WassonRV10/hangar-mate/presentation/hangar-mate-chapter-talk.pdf

E A A C H A P T E R 3 2 · 1 1 / 2 1 / 2 0 2 6

# PREHEAT FROM HOME

## A cellular Tanis controller you can build yourself — no hangar Wi-Fi, no

monthly fee, and it tells you the engine is actually warming.

Brian Wasson · RV-10 · KSET

T H E P R O B L E M

# The Tanis wants hours. The hangar is 40 minutes

away.

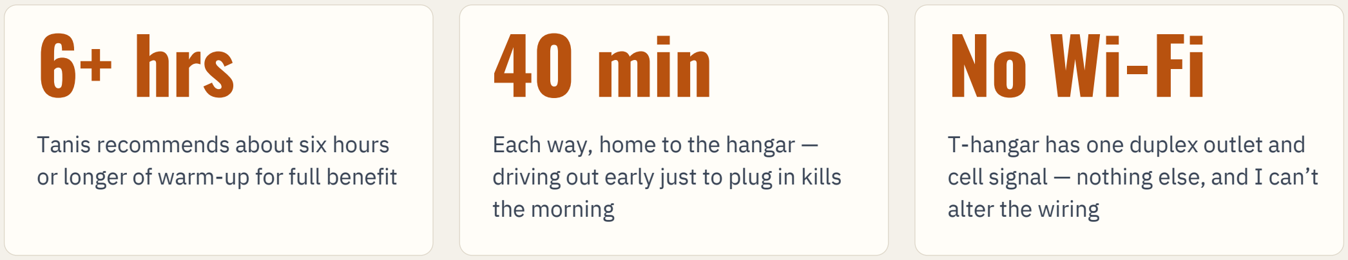
[picture p1: figure]
6+ hrs; Tanis recommends about six hours or longer of warm-up for full benefit; 40 min; Each way, home to the hangar — driving out early just to plug in kills the morning; T-hangar has one duplex outlet and cell signal — nothing else, and I can’t alter the wiring

W H A T ’ S O N T H E S H E L F
Plenty of ways to switch an outlet. Few tell you it worked.
Option | Upfront | Ongoing | Confirms it’s heating?
HangarBot preheat kit | $729 | $15 Monthly data plan | No — switches the outlet
SwitcheOn (sold by Tanis) | $323 | $50/yr | No — switches the outlet
Wi-Fi plug + hotspot | ~$60–100 | Hotspot plan | No — two things to fail
Plug-in timer | ~$30 | None | No — and Tanis says no timers

Prices: Aircraft Spruce listing (HangarBot), Tanis website Oct 2026 (SwitcheOn); verify before quoting.

W H Y I B U I L T O N E

# I wanted confidence, not just a remote switch

### Proof it’s working

Engine and hangar temps on my phone — I see the rise before I leave home

### No monthly bill

Particle’s free plan includes the cellular data for a device like this

### Built around Tanis rules

On means on — no cycling, no timer, no thermostat on the engine heater

### Grows with me

Cabin heat, flood warning and more bolt on later without starting over

E X P A N S I O N P A T H
Start with preheat. Add the rest when you want it.
Add-on | What you add | What you get
Cabin heat | Second relay + cabin probe + ceramic heater | Warm seats, auto shut-off timer
Current sensor | Clamp-on CT on the Tanis circuit | “Confirmed on” in seconds; stuck-relay alarm
Power-loss alert | Small LiPo battery on the controller | Alert when hangar power drops
Flood warning | River-gauge alerts + floor water sensor | Lead time to fly the airplane out
Activity & lights | Motion sensor + light sensor | FBO visit log; lights-left-on alert

The controller has spare inputs for all of these. No rewiring of what you already built.

T H E C U R R E N T B U I L D
Two relays. Three temperature probes. One phone.

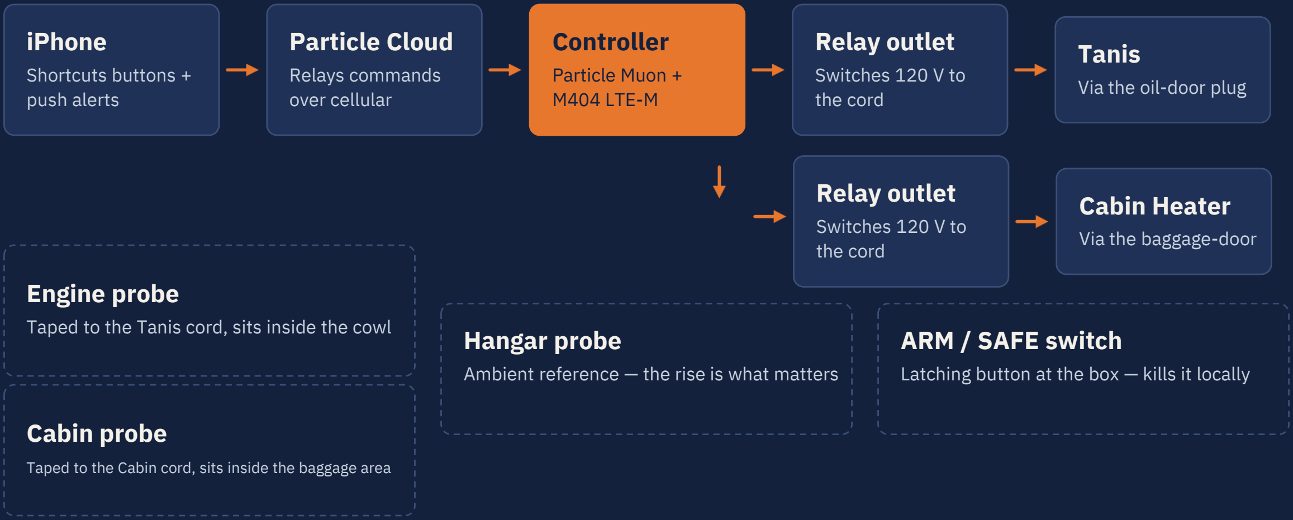
[picture p2: figure]
iPhone; Shortcuts buttons + push alerts; Particle Cloud; Relays commands over cellular; Controller; Particle Muon + M404 LTE-M; Relay outlet; Switches 120 V to the cord; Tanis; Via the oil-door plug; Engine probe; ARM / SAFE switch; Cabin Heater; Via the baggage-door; Cabin probe

Taped to the Tanis cord, sits inside the cowl | Hangar probe
| Ambient reference — the rise is what matters

Latching button at the box — kills it locally

Taped to the Cabin cord, sits inside the baggage area

# THE FULL BUILD

# 5V Power DINRail

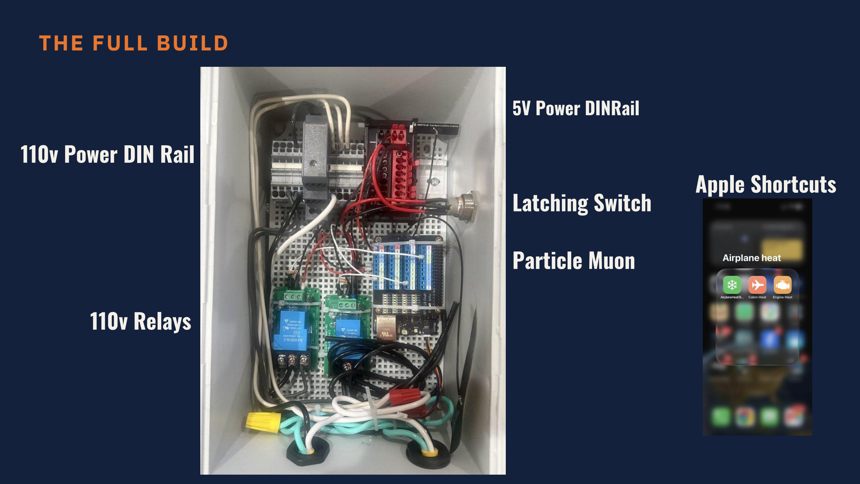
[picture p3: page 7]

# 110v Relays

# Particle Muon

# Latching Switch

# 110v Power DIN Rail Apple Shortcuts

F A I L -S A F E B Y D E S I G N

# When anything fails, the heat goes off — not on

If this happens… | …the result is
Controller dies or loses power | Relay drops open — outlet off
Cell signal or cloud goes down | Outlet holds its state; phone shows “state unknown”
ARM/SAFE button set to SAFE | Relay can’t energize, in hardware, whatever the firmware does
Re-armed after SAFE | Stays off until someone sends a new command
Fueling or engine start | Use your head - Unplugged first!

Kit and bridge prices from vendor listings, Oct 2026. total is an estimate.

W H A T I T C O S T S

Part | Approx.
Particle Muon kit, North America (M404 LTE-M) | $85
2 - 30 A relay module, opto-isolated input | $5
Waterproof DS18B20 probes (3 pack) | $6
Adafruit DS2484 probe bridge + Qwiic cable | $15
Mean Well 12v DIN rail power supply | $14
8 out DIN rail power distribution | $15
Plastic NEMA 4 box, 15 A; with DIN Rail | $38
Latching lit button, screw-terminal HAT, resistors | $19
12-ga outdoor extension cord (if needed) | $25
2 ft 12-ga outlets | $17
3 conductor 22 awg 50ft | $20
Deutsch Connectors | $10
WAGO DIN rail connector | $15
TOTAL | $284

Estimated total

~$284

Monthly

$0

Particle Free Plan: up to 100 devices, 100K data operations/month, cellular data included

W H A T I T T A K E S T O B U I L D O N E

# If you can wire a panel, you can build this

### Skills

Relays module and pigtail outlets in an electrical box, screw terminals and a multimeter. Simpler than any panel you’ve wired.

### Software

No coding. Set up the device in a browser, flash my shared firmware, install iPhone Shortcuts.

### Time

An evening on the bench, an hour at the hangar, then a 24–48 hour soak test before you trust it.

You’ll need: an iPhone, cell signal inside your hangar (we test that first), and a Tanis or similar plug-in preheater.

I N S I D E T H E B O X

# Four details that make it fail safe

### Load on COM → NO, never NC

A dead relay means a dead outlet. Wired through NC, it would heat whenever the controller is off.

### Active-high + 15 kΩ pull-down

In active-low mode the outlet came on at power-up. Active-high keeps it off before firmware runs.

### ARM/SAFE cuts relay power

The latching button is in the relay’s 5 V feed. SAFE means no coil power, whatever the code does.

### Non-metallic enclosure

Non-metallic electrical enclosure. Listed polycarbonate recommended to contain a 120 V fault near fuel; doesn’t block the cellular antenna..

# Build a Minimum Product

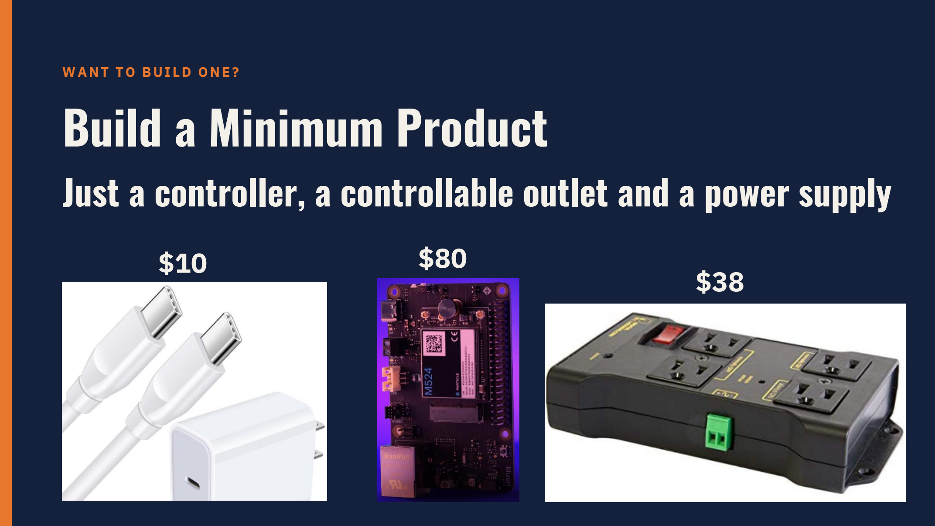
[picture p4: page 12]

W A N T T O B U I L D O N E ?

$80
$38

# Just a controller, a controllable outlet and a power supply

$10

# Project Documentation

GitHub Repository:

WassonRV10/hangar (https://github.com/WassonRV10/hangar-mate)- (https://github.com/WassonRV10/hangar-mate)mate: Cellular Pre (https://github.com/WassonRV10/hangar-mate)- (https://github.com/WassonRV10/hangar-mate)heat manager (https://github.com/WassonRV10/hangar-mate)
