WassonRV10/hangar-mate/presentation/README.md

# Presentation

EAA chapter presentation: "Preheat From Home — DIY Cellular Hangar Controller."

See `hangar-mate-chapter-talk.pdf`.
