WassonRV10/hangar-mate/(commit log)

2026-11-02 Add relay firmware with toggle; update guide for one-tap Preheat Shortcut
    - firmware/src/hangar_mate.ino: tanis/cabin accept toggle; return codes
    report resulting state (1 on, 0 off, -1 bad arg, -2 SAFE); every
    command refused while SAFE; sense pin INPUT_PULLDOWN; no Tanis timer
    - firmware/README.md: implemented interface vs. still-to-come
    - docs/builders-guide.md: Preheat toggle Shortcut, return-code table,
    build steps, bench tests and troubleshooting updated
    - README.md: status and layout
    Claude-Session: https://claude.ai/code/session_018Rj49QWAzRy1FNSQnHF3T7
    [hangar_mate.ino]
2026-11-02 Presentation PDF: correct probe cost and total ($286)
    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
2026-11-07 PRD v0.19: merge Section 9A to match firmware; bring in v0.18 FR-003a
    - Section 9A merged into docs/PRD.md and updated to the firmware as built:
    tanis/cabin on|off|toggle, return codes report resulting state, -2 for
    SAFE or not-yet-read, implemented variables and events
    - Owner decisions: Phase 1 allowance on IF-003 (labeled 'heat not yet
    confirmed'), cabin duration argument dropped, 8-12 V DIN-rail supply
    to VIN, LoRaWAN not used
    - New IF-010: no automatic retry (toggle is not idempotent)
    - Draft open items 32-37 renumbered 36-40 to avoid Section 25 collisions
    - Stale 'M-SoM not yet selected' text updated
    - Builder's guide, README and firmware README updated to match
    Co-Authored-By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
2026-11-07 PRD v0.20: record Joinfworld enclosure as accepted deviation from ER-005
    Claude-Session: https://claude.ai/code/session_018Rj49SwcFPazYrWtiNanW4
2026-11-07 Builder's guide: keep listed enclosure recommendation, add prototype's box as alternate
    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
2026-11-07 Builder's guide: pigtail outputs, WAGO blocks, DC distribution, Deutsch probe disconnect
    AC side rewritten for 12-ga pigtail cords through glands (no receptacle in
    the box). Warns that relay DC+ must come from the ARM/SAFE switch, not the
    DIN-rail distribution module. PRD v0.20 ER-005 updated to match.
    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
2026-11-07 Presentation: current build, NEMA box, enclosure wording, cost slide $284
    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
2026-11-07 Presentation: enclosure heading and build-skills wording updated
    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
2026-11-13 Add 1-Wire bring-up sketch for DS2484 and DS18B20 probes
    Standalone diagnostic: I2C scan, DS2484 init, ROM search with CRC and
    abort counts, continuous readings, and disconnect detection, reported
    over USB serial and the Particle Cloud. Includes the prototype probe map
    confirmed on 2026-11-12.
    Claude-Session: https://claude.ai/code/session_018Rj49SQwmVM8JeAkMfh8fF
2026-11-13 Firmware v0.2.0: temperatures, status, alloff, FR-003a and long-run checks
    - DS18B20 probes via the DS2484 I2C bridge, read every 30 s without
    blocking the loop, mapped by ROM ID to ENGINE/CABIN/HANGAR
    - status variable (JSON) per PRD 9A.4 / IF-002
    - alloff function
    - FR-003a preheat effectiveness check (hm/eng/norise, hm/eng/ok),
    30 min / 5 F defaults, notification only
    - TSR-002 long-run notice (hm/tanis/longrun) after 24 h, notification only
    - hm/boot event
    Relay, ARM/SAFE and cabin-timeout behavior unchanged.
    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
2026-11-13 PRD v0.21: DS2484 bench-verified, firmware v0.2.0 status updates
    Closes Section 25 item 34. Marks status, alloff, hm/eng/norise,
    hm/eng/ok, hm/tanis/longrun and hm/boot implemented (not yet verified
    on hardware), updates the 9A.4 status format to match the firmware,
    and adds the bench-check-each-probe builder note.
    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
2026-11-13 Docs: sync README and builder's guide with firmware v0.2.0 and PRD v0.21
    - README: probes bench-verified, v0.2.0 features listed, PRD v0.21, workflow row
    - Builder's guide: DS2484 marked done; probe setup rewritten to use the
    bring-up sketch and PROBE_ROM (setprobe still planned); All Off and
    Hangar Status now use alloff/status; check-each-probe-alone note;
    alert threshold points to the firmware constants; PRD v0.21
    - Bring-up README: main firmware table is PROBE_ROM, not PROBE_MAP
    Claude-Session: https://claude.ai/code/session_018Rj49SAUcga9qSyg7GVrqq
2026-11-13 Builder's guide: full build is the main guide; minimum build is outlet-only
    - Main guide now covers the prototype as built: two relays and pigtails,
    three probes, ARM/SAFE on both relays, cabin heater rules and run-time limit,
    Cabin Heat Shortcut, cabin bench test, cabin daily use
    - New Section 13: minimum build = Muon + one controllable outlet; no probes,
    no cabin heat, no ARM/SAFE switch. Its firmware is a separate project; until
    then it can run v0.2.0 with D4 tied high through the divider
    - README: full build and minimum build descriptions updated
    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
